chipsandtea/eink-display/enclosure/stl/frame_button.stl

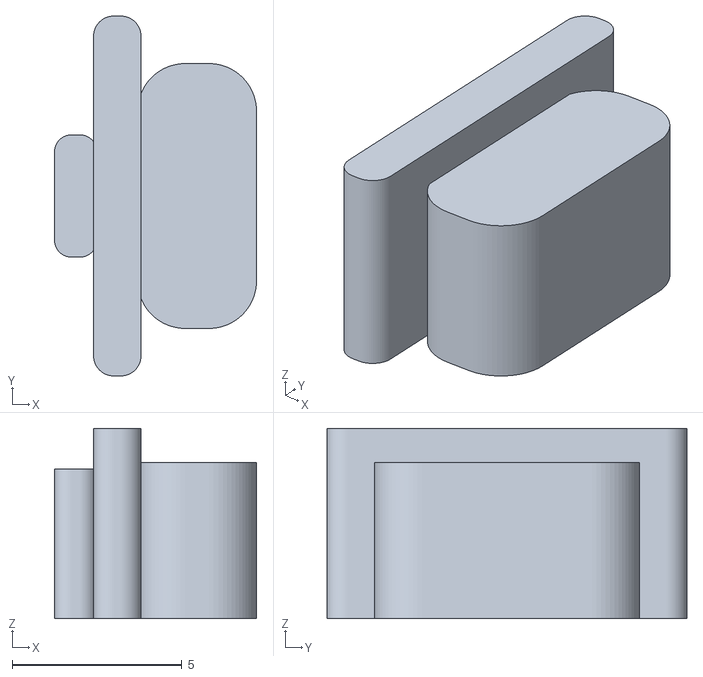
[picture p1: CAD file, 2026-11-03]
enclosure/stl/frame_button.stl
5.95 x 10.6 x 5.60
