chipsandtea/eink-display/enclosure/stl/frame_kickstand.stl

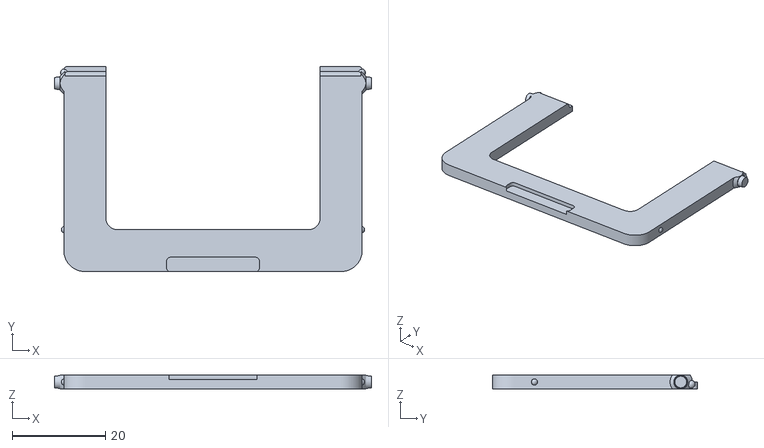
[picture p2: CAD file, 2026-11-03]
enclosure/stl/frame_kickstand.stl
68.0 x 44.0 x 3.00
