chipsandtea/eink-display/enclosure/stl/frame_front.stl

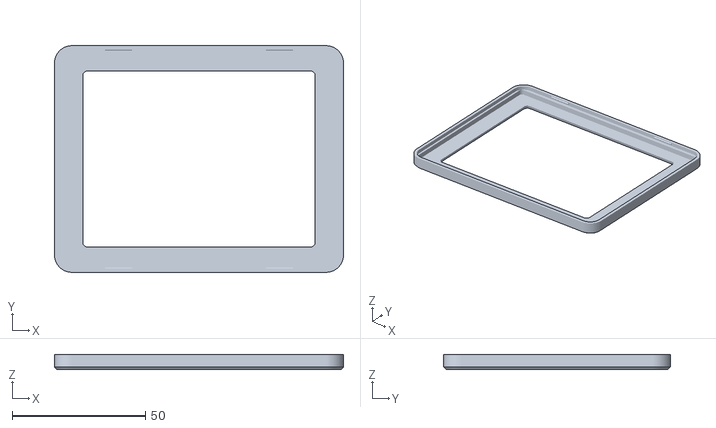
[picture p3: CAD file, 2026-11-03]
enclosure/stl/frame_front.stl
108.4 x 85.0 x 5.80
