chipsandtea/eink-display/enclosure/stl/frame_back.stl

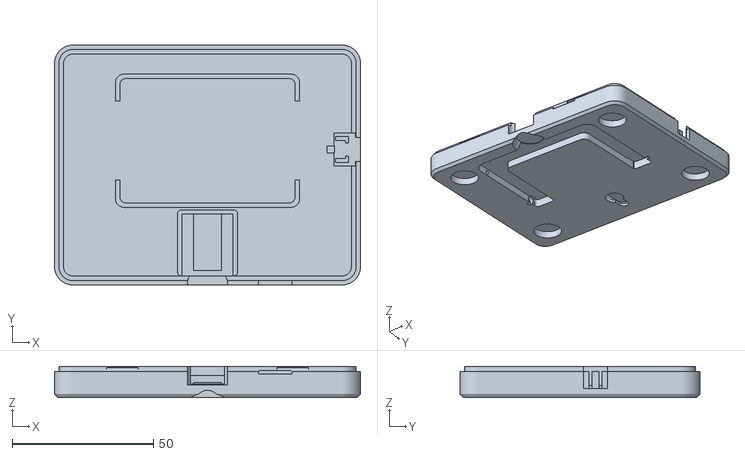
[picture p4: CAD file, 2026-11-03]
enclosure/stl/frame_back.stl
108.4 x 85.0 x 11.0
