chipsandtea/eink-display/(commit log)

2026-09-27 feat: initial DIY e-ink photo album implementation and plan
    [partitions_16MB.csv]
2026-09-27 feat(enclosure): add parametric 3D printable OpenSCAD frame model
    [frame.scad]
2026-09-27 fix(firmware): resolve GxEPD2 4-color driver and LittleFS storage compilation
    [frame.scad, partitions_16MB.csv]
2026-10-26 Target XIAO ESP32S3, unify web UI with gallery previews, and fix firmware bugs
    [partitions_16MB.csv, partitions_8MB.csv]
2026-10-26 Redesign enclosure with slim symmetric bezels, U-ring kickstand, and 12x3mm magnet pockets
    [frame.scad]
2026-10-30 Relocate button to upper-right, add angled prong clearance, and tune tactile click stroke
    [frame.scad]
2026-10-30 Add full-extension click detents and 58-degree planar hard stops to kickstand hinge
    [frame.scad, frame_back.stl, frame_button.stl, frame_front.stl, frame_kickstand.stl]
2026-11-03 Fix sideways switch cradle, kickstand detent interference, stepped bezel skirt, and back print orientation
    [frame.scad, frame_back.stl, frame_button.stl, frame_front.stl, frame_kickstand.stl]
